CannibalPizza/ECE_445_Project/notebooks/Alex/Block Diagram v3.0.png

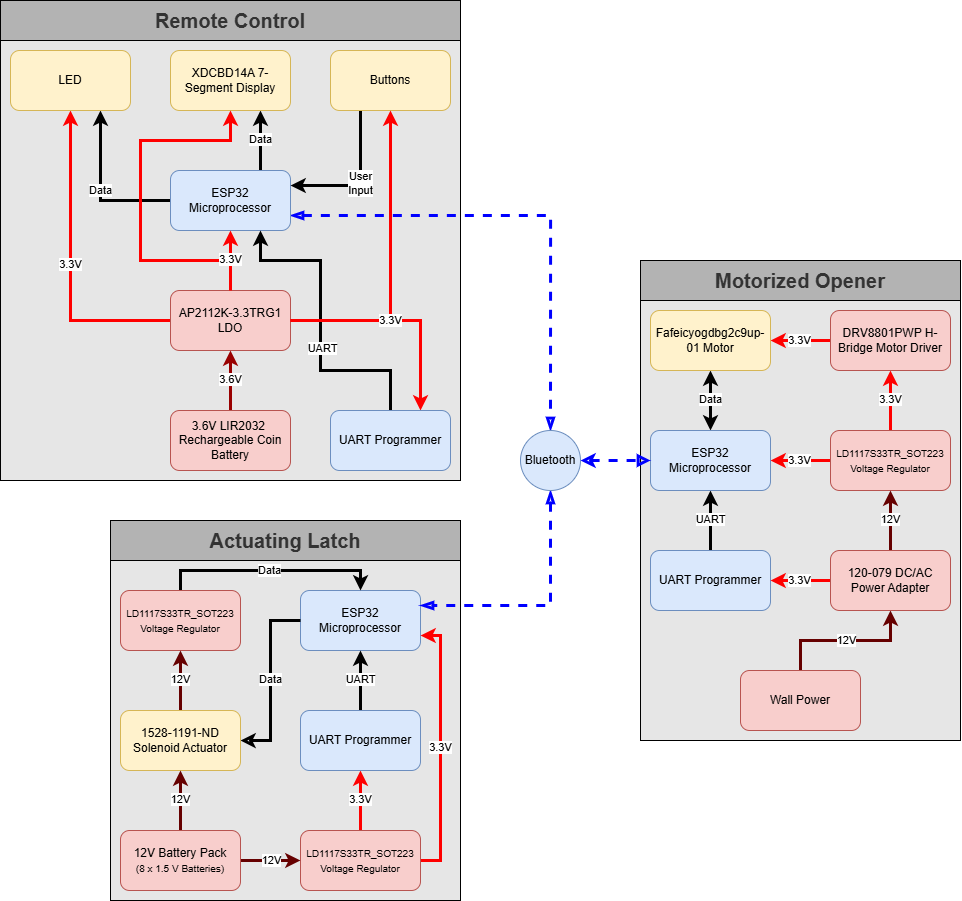
notebooks/Alex/Block Diagram v3.0.png
