CannibalPizza/ECE_445_Project/notebooks/Romeo/Alternate_Latch_Schematic.png

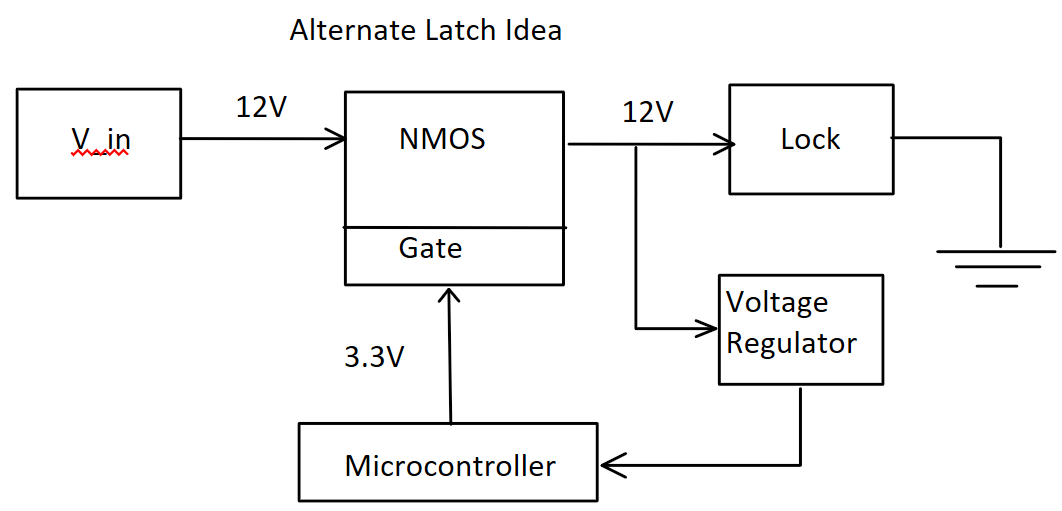
notebooks/Romeo/Alternate_Latch_Schematic.png
