CannibalPizza/ECE_445_Project/notebooks/Romeo/BlueTooth Connections.png

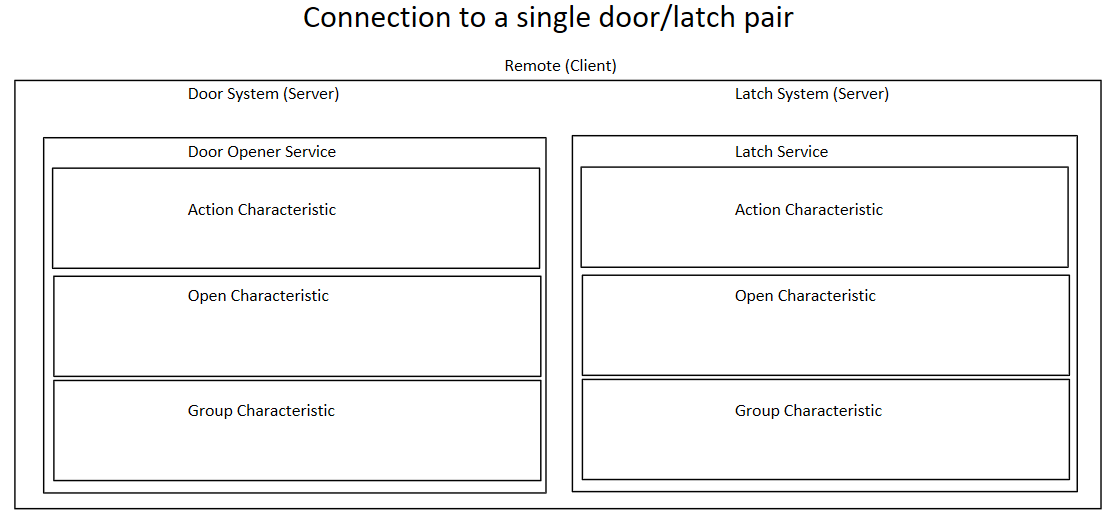
notebooks/Romeo/BlueTooth Connections.png
