CannibalPizza/ECE_445_Project/notebooks/Romeo/Modified_Updated_Door_System_Sketch.png

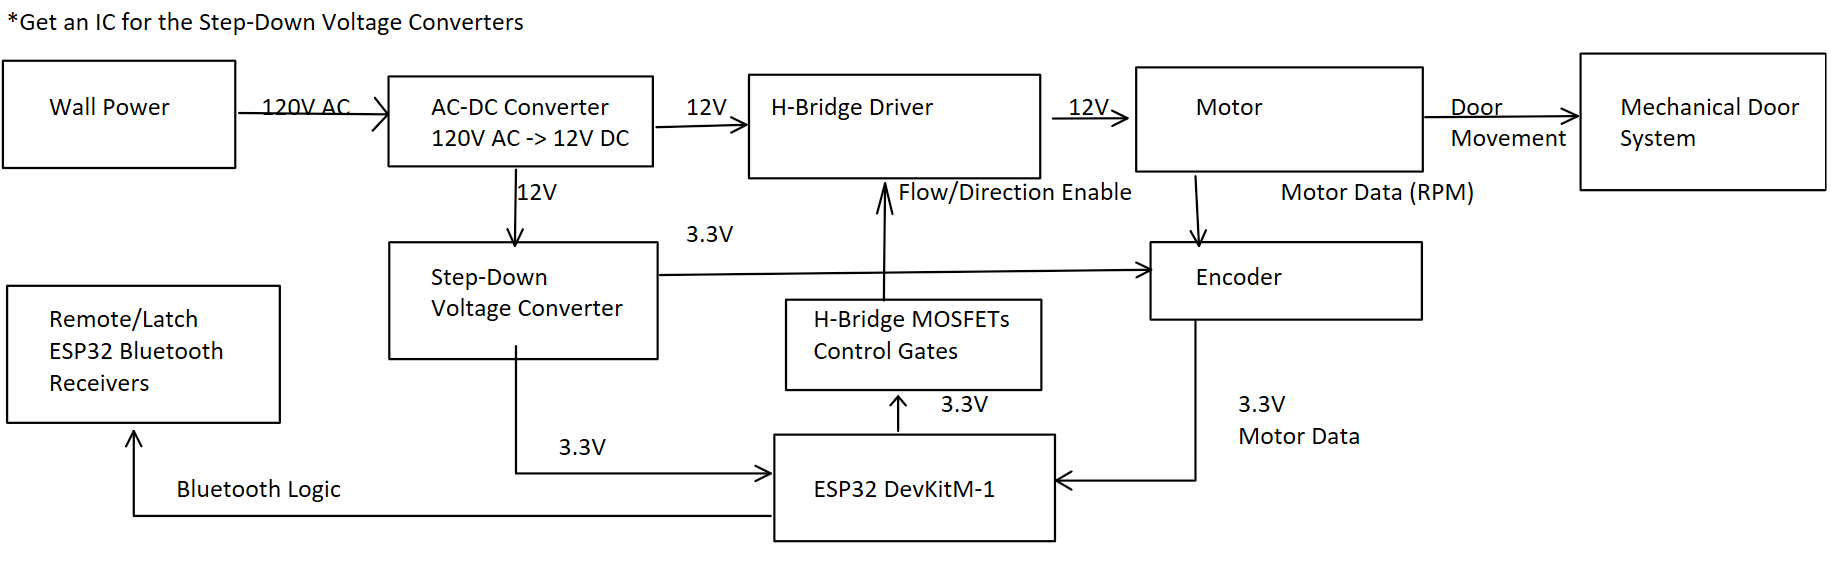
notebooks/Romeo/Modified_Updated_Door_System_Sketch.png
